wheuer/LEDCube/Docs/Images/box-turtle-silhouette-000000-original.png

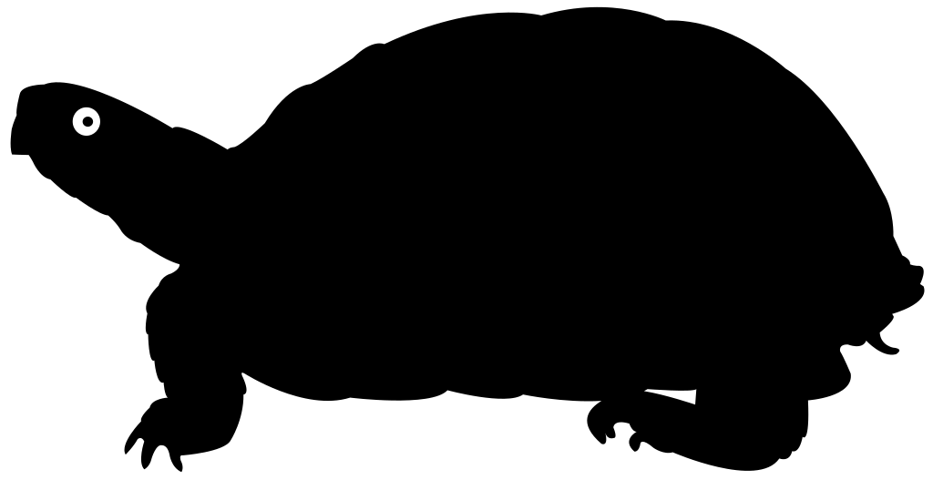
Docs/Images/box-turtle-silhouette-000000-original.png
