wheuer/LEDCube/Docs/Images/temp_pinout.png

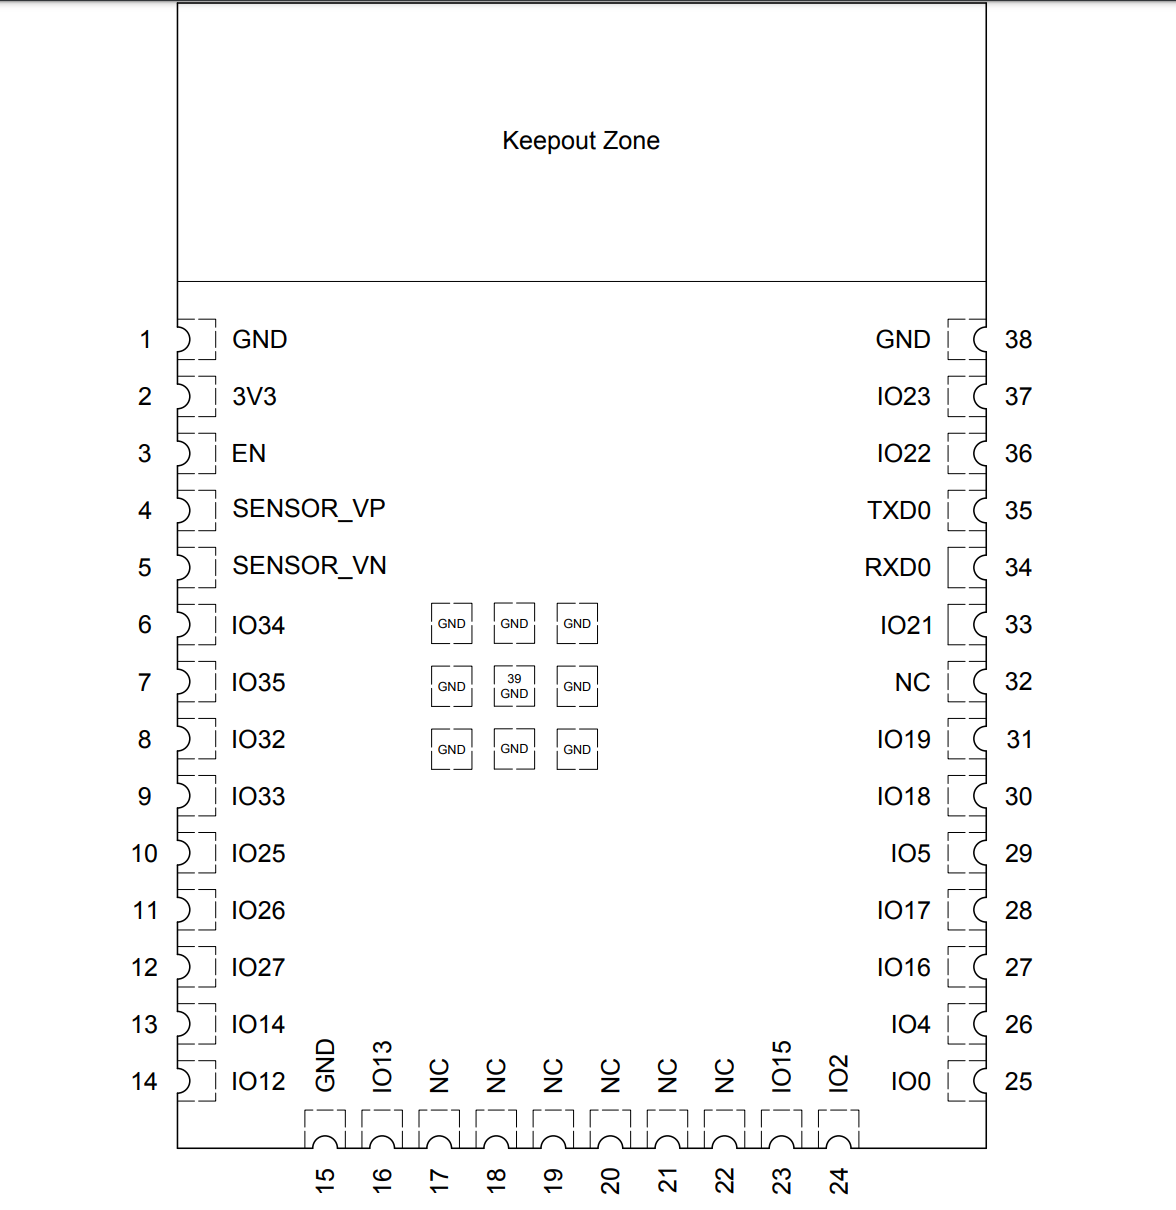
Docs/Images/temp_pinout.png
