wheuer/LEDCube/KiCadPanel/KiCadPanel/KiCadPanel.kicad_pcb

## KiCad design KiCadPanel/KiCadPanel/KiCadPanel.kicad_pcb (2023-10-04)

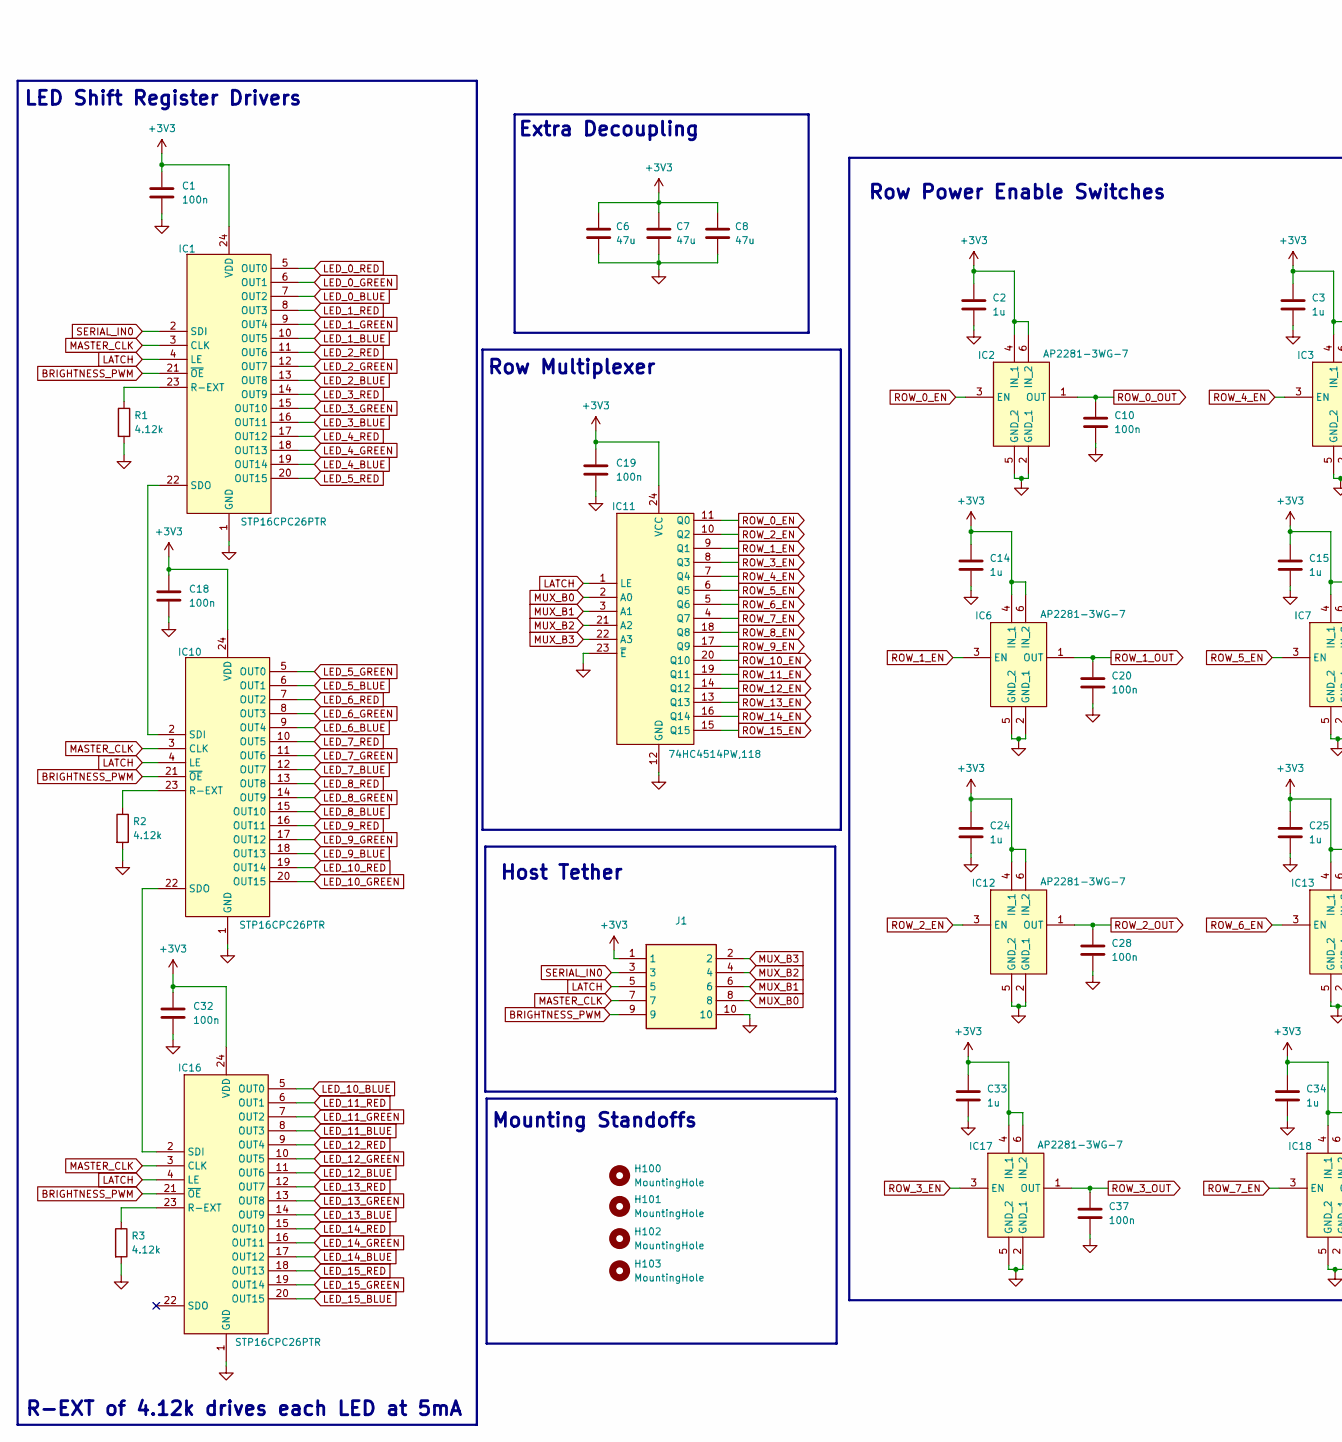
[picture p3: schematic KiCadPanel.kicad_sch, part in row 1, column 1]

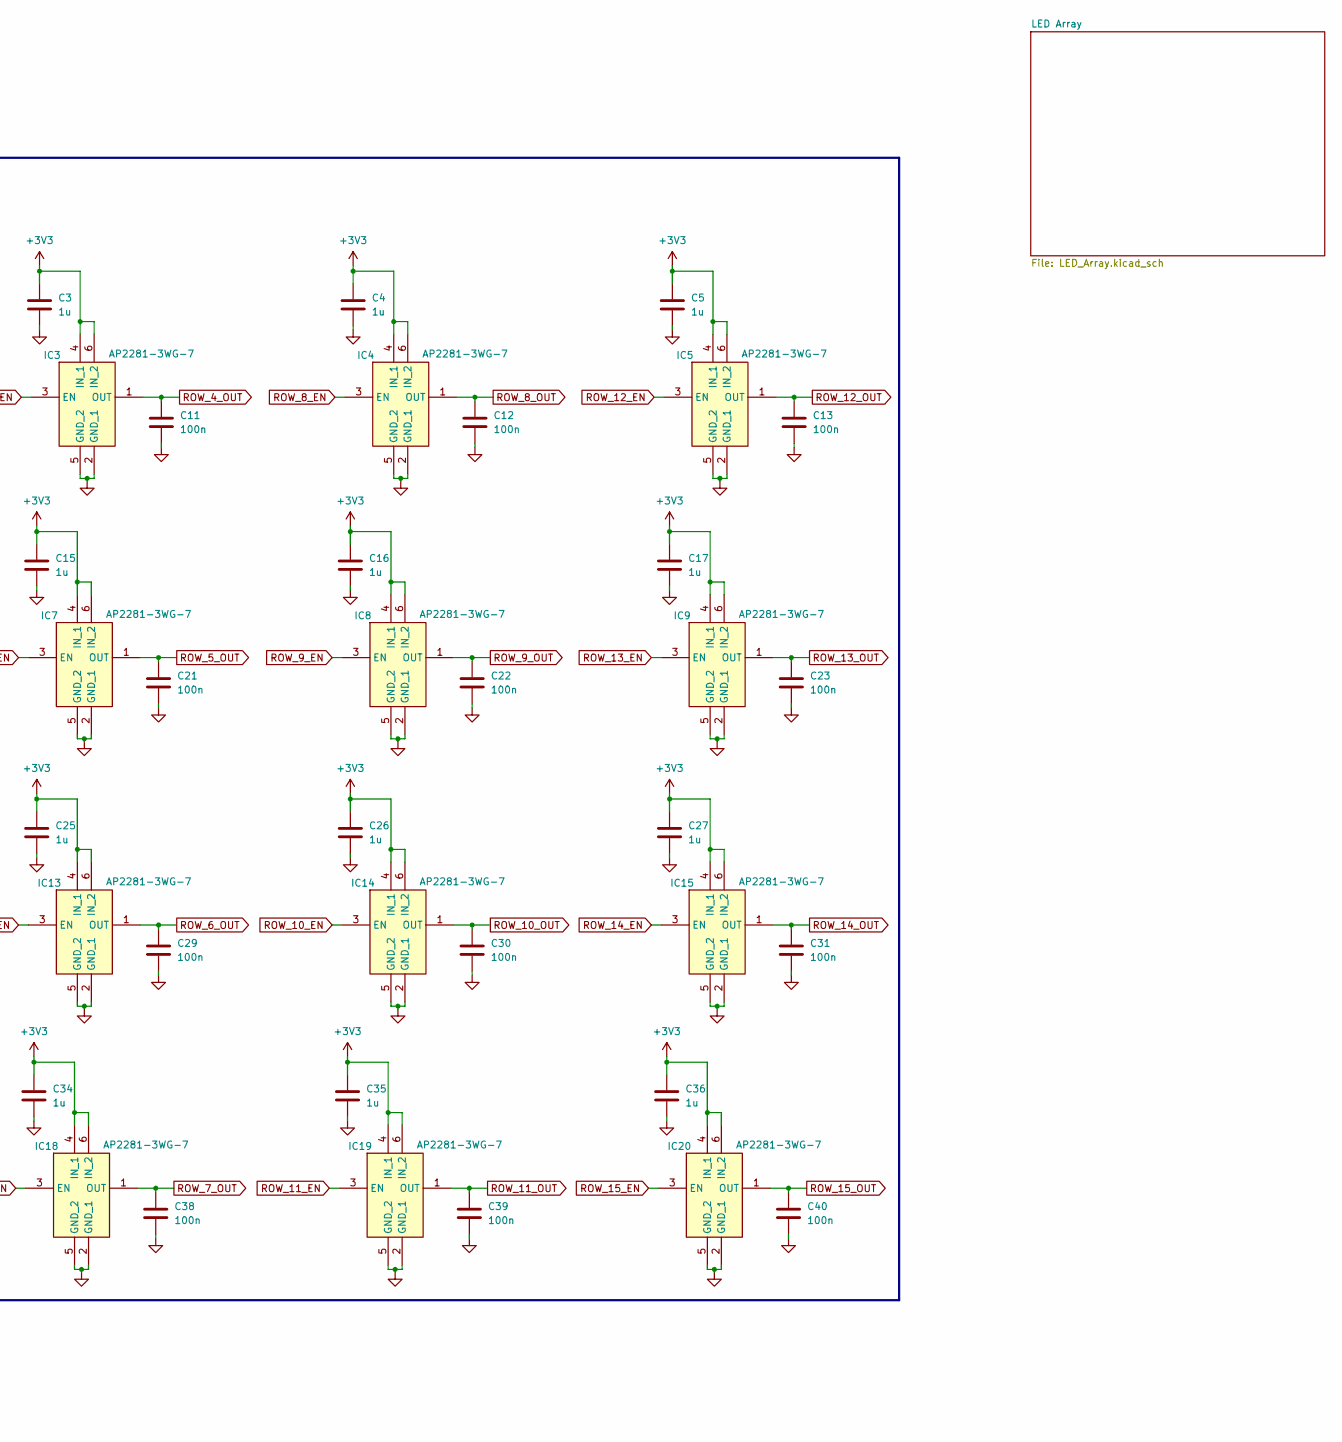
[picture p4: schematic KiCadPanel.kicad_sch, part in row 1, column 2]

Parts:
C1, C10, C11, C12, C13, C18, C19, C20, C21, C22, C23, C28, C29, C30, C31, C32, C37, C38, C39, C40: 100n; C_0603_1608Metric
C2, C3, C4, C5, C14, C15, C16, C17, C24, C25, C26, C27, C33, C34, C35, C36: 1u; C_0603_1608Metric
C6, C7, C8: 47u; C_1206_3216Metric
H100, H101, H102, H103: MountingHole; Mounting_Wuerth_WA-SMSE-ExternalM3_H5mm_9771050360
IC1, IC10, IC16: STP16CPC26PTR; SOP64P600X173-24N; Mouser Part Number 511-STP16CPC26PTR
IC2, IC3, IC4, IC5, IC6, IC7, IC8, IC9, IC12, IC13, IC14, IC15, IC17, IC18, IC19, IC20: AP2281-3WG-7; SOT95P285X140-6N; Mouser Part Number 621-AP2281-3WG-7
IC11: 74HC4514PW,118; SOP65P640X110-24N; Mouser Part Number 771-HC4514PW118
J1: CNC_TECH_SMD_10POS; Manufacturer_Part_Number 15-91-0100
R1, R2, R3: 4.12k; R_0603_1608Metric

Connections:
+3V3: C1.1, C2.1, C3.1, C4.1, C5.1, C6.1, C7.1, C8.1, C14.1, C15.1, C16.1, C17.1, C18.1, C19.1, C24.1, C25.1, C26.1, C27.1, C32.1, C33.1, C34.1, C35.1, C36.1, IC1.24 (VDD), IC2.4 (IN_1), IC2.6 (IN_2), IC3.4 (IN_1), IC3.6 (IN_2), IC4.4 (IN_1), IC4.6 (IN_2), IC5.4 (IN_1), IC5.6 (IN_2), IC6.4 (IN_1), IC6.6 (IN_2), IC7.4 (IN_1), IC7.6 (IN_2), IC8.4 (IN_1), IC8.6 (IN_2), IC9.4 (IN_1), IC9.6 (IN_2), IC10.24 (VDD), IC11.24 (VCC), IC12.4 (IN_1), IC12.6 (IN_2), IC13.4 (IN_1), IC13.6 (IN_2), IC14.4 (IN_1), IC14.6 (IN_2), IC15.4 (IN_1), IC15.6 (IN_2), IC16.24 (VDD), IC17.4 (IN_1), IC17.6 (IN_2), IC18.4 (IN_1), IC18.6 (IN_2), IC19.4 (IN_1), IC19.6 (IN_2), IC20.4 (IN_1), IC20.6 (IN_2), J1.1
BRIGHTNESS_PWM: IC1.21 (~OE), IC10.21 (~OE), IC16.21 (~OE), J1.9
GND: C1.2, C2.2, C3.2, C4.2, C5.2, C6.2, C7.2, C8.2, C10.2, C11.2, C12.2, C13.2, C14.2, C15.2, C16.2, C17.2, C18.2, C19.2, C20.2, C21.2, C22.2, C23.2, C24.2, C25.2, C26.2, C27.2, C28.2, C29.2, C30.2, C31.2, C32.2, C33.2, C34.2, C35.2, C36.2, C37.2, C38.2, C39.2, C40.2, IC1.1 (GND), IC2.2 (GND_1), IC2.5 (GND_2), IC3.2 (GND_1), IC3.5 (GND_2), IC4.2 (GND_1), IC4.5 (GND_2), IC5.2 (GND_1), IC5.5 (GND_2), IC6.2 (GND_1), IC6.5 (GND_2), IC7.2 (GND_1), IC7.5 (GND_2), IC8.2 (GND_1), IC8.5 (GND_2), IC9.2 (GND_1), IC9.5 (GND_2), IC10.1 (GND), IC11.12 (GND), IC11.23 (~E), IC12.2 (GND_1), IC12.5 (GND_2), IC13.2 (GND_1), IC13.5 (GND_2), IC14.2 (GND_1), IC14.5 (GND_2), IC15.2 (GND_1), IC15.5 (GND_2), IC16.1 (GND), IC17.2 (GND_1), IC17.5 (GND_2), IC18.2 (GND_1), IC18.5 (GND_2), IC19.2 (GND_1), IC19.5 (GND_2), IC20.2 (GND_1), IC20.5 (GND_2), J1.10, R1.2, R2.2, R3.2
LATCH: IC1.4 (LE), IC10.4 (LE), IC11.1 (LE), IC16.4 (LE), J1.5
LED_0_BLUE: IC1.7 (OUT2); also elsewhere on the board
LED_0_GREEN: IC1.6 (OUT1); also elsewhere on the board
LED_0_RED: IC1.5 (OUT0); also elsewhere on the board
LED_1_BLUE: IC1.10 (OUT5); also elsewhere on the board
LED_1_GREEN: IC1.9 (OUT4); also elsewhere on the board
LED_1_RED: IC1.8 (OUT3); also elsewhere on the board
LED_2_BLUE: IC1.13 (OUT8); also elsewhere on the board
LED_2_GREEN: IC1.12 (OUT7); also elsewhere on the board
LED_2_RED: IC1.11 (OUT6); also elsewhere on the board
LED_3_BLUE: IC1.16 (OUT11); also elsewhere on the board
LED_3_GREEN: IC1.15 (OUT10); also elsewhere on the board
LED_3_RED: IC1.14 (OUT9); also elsewhere on the board
LED_4_BLUE: IC1.19 (OUT14); also elsewhere on the board
LED_4_GREEN: IC1.18 (OUT13); also elsewhere on the board
LED_4_RED: IC1.17 (OUT12); also elsewhere on the board
LED_5_BLUE: IC10.6 (OUT1); also elsewhere on the board
LED_5_GREEN: IC10.5 (OUT0); also elsewhere on the board
LED_5_RED: IC1.20 (OUT15); also elsewhere on the board
LED_6_BLUE: IC10.9 (OUT4); also elsewhere on the board
LED_6_GREEN: IC10.8 (OUT3); also elsewhere on the board
LED_6_RED: IC10.7 (OUT2); also elsewhere on the board
LED_7_BLUE: IC10.12 (OUT7); also elsewhere on the board
LED_7_GREEN: IC10.11 (OUT6); also elsewhere on the board
LED_7_RED: IC10.10 (OUT5); also elsewhere on the board
LED_8_BLUE: IC10.15 (OUT10); also elsewhere on the board
LED_8_GREEN: IC10.14 (OUT9); also elsewhere on the board
LED_8_RED: IC10.13 (OUT8); also elsewhere on the board
LED_9_BLUE: IC10.18 (OUT13); also elsewhere on the board
LED_9_GREEN: IC10.17 (OUT12); also elsewhere on the board
LED_9_RED: IC10.16 (OUT11); also elsewhere on the board
LED_10_BLUE: IC16.5 (OUT0); also elsewhere on the board
LED_10_GREEN: IC10.20 (OUT15); also elsewhere on the board
LED_10_RED: IC10.19 (OUT14); also elsewhere on the board
LED_11_BLUE: IC16.8 (OUT3); also elsewhere on the board
LED_11_GREEN: IC16.7 (OUT2); also elsewhere on the board
LED_11_RED: IC16.6 (OUT1); also elsewhere on the board
LED_12_BLUE: IC16.11 (OUT6); also elsewhere on the board
LED_12_GREEN: IC16.10 (OUT5); also elsewhere on the board
LED_12_RED: IC16.9 (OUT4); also elsewhere on the board
LED_13_BLUE: IC16.14 (OUT9); also elsewhere on the board
LED_13_GREEN: IC16.13 (OUT8); also elsewhere on the board
LED_13_RED: IC16.12 (OUT7); also elsewhere on the board
LED_14_BLUE: IC16.17 (OUT12); also elsewhere on the board
LED_14_GREEN: IC16.16 (OUT11); also elsewhere on the board
LED_14_RED: IC16.15 (OUT10); also elsewhere on the board
LED_15_BLUE: IC16.20 (OUT15); also elsewhere on the board
LED_15_GREEN: IC16.19 (OUT14); also elsewhere on the board
LED_15_RED: IC16.18 (OUT13); also elsewhere on the board
MASTER_CLK: IC1.3 (CLK), IC10.3 (CLK), IC16.3 (CLK), J1.7
MUX_B0: IC11.2 (A0), J1.8
MUX_B1: IC11.3 (A1), J1.6
MUX_B2: IC11.21 (A2), J1.4
MUX_B3: IC11.22 (A3), J1.2
unnamed: IC1.23 (R-EXT), R1.1
unnamed: IC1.22 (SDO), IC10.2 (SDI)
unnamed: IC10.23 (R-EXT), R2.1
unnamed: IC10.22 (SDO), IC16.2 (SDI)
unnamed: IC16.23 (R-EXT), R3.1
ROW_0_EN: IC2.3 (EN), IC11.11 (Q0)
ROW_0_OUT: C10.1, IC2.1 (OUT); also elsewhere on the board
ROW_1_EN: IC6.3 (EN), IC11.9 (Q1)
ROW_1_OUT: C20.1, IC6.1 (OUT); also elsewhere on the board
ROW_2_EN: IC11.10 (Q2), IC12.3 (EN)
ROW_2_OUT: C28.1, IC12.1 (OUT); also elsewhere on the board
ROW_3_EN: IC11.8 (Q3), IC17.3 (EN)
ROW_3_OUT: C37.1, IC17.1 (OUT); also elsewhere on the board
ROW_4_EN: IC3.3 (EN), IC11.7 (Q4)
ROW_4_OUT: C11.1, IC3.1 (OUT); also elsewhere on the board
ROW_5_EN: IC7.3 (EN), IC11.6 (Q5)
ROW_5_OUT: C21.1, IC7.1 (OUT); also elsewhere on the board
ROW_6_EN: IC11.5 (Q6), IC13.3 (EN)
ROW_6_OUT: C29.1, IC13.1 (OUT); also elsewhere on the board
ROW_7_EN: IC11.4 (Q7), IC18.3 (EN)
ROW_7_OUT: C38.1, IC18.1 (OUT); also elsewhere on the board
ROW_8_EN: IC4.3 (EN), IC11.18 (Q8)
ROW_8_OUT: C12.1, IC4.1 (OUT); also elsewhere on the board
ROW_9_EN: IC8.3 (EN), IC11.17 (Q9)
ROW_9_OUT: C22.1, IC8.1 (OUT); also elsewhere on the board
ROW_10_EN: IC11.20 (Q10), IC14.3 (EN)
ROW_10_OUT: C30.1, IC14.1 (OUT); also elsewhere on the board
ROW_11_EN: IC11.19 (Q11), IC19.3 (EN)
ROW_11_OUT: C39.1, IC19.1 (OUT); also elsewhere on the board
ROW_12_EN: IC5.3 (EN), IC11.14 (Q12)
ROW_12_OUT: C13.1, IC5.1 (OUT); also elsewhere on the board
ROW_13_EN: IC9.3 (EN), IC11.13 (Q13)
ROW_13_OUT: C23.1, IC9.1 (OUT); also elsewhere on the board
ROW_14_EN: IC11.16 (Q14), IC15.3 (EN)
ROW_14_OUT: C31.1, IC15.1 (OUT); also elsewhere on the board
ROW_15_EN: IC11.15 (Q15), IC20.3 (EN)
ROW_15_OUT: C40.1, IC20.1 (OUT); also elsewhere on the board
SERIAL_IN0: IC1.2 (SDI), J1.3

Notes on the sheet:
LED Shift Register Drivers
Row Power Enable Switches
R-EXT of 4.12k drives each LED at 5mA
Host Tether
Row Multiplexer
Extra Decoupling
Mounting Standoffs
