wheuer/LEDCube/KiCadPanel/KiCadPanel/KiCadPanel.kicad_pcb

## KiCad design KiCadPanel/KiCadPanel/KiCadPanel.kicad_pcb (continued)

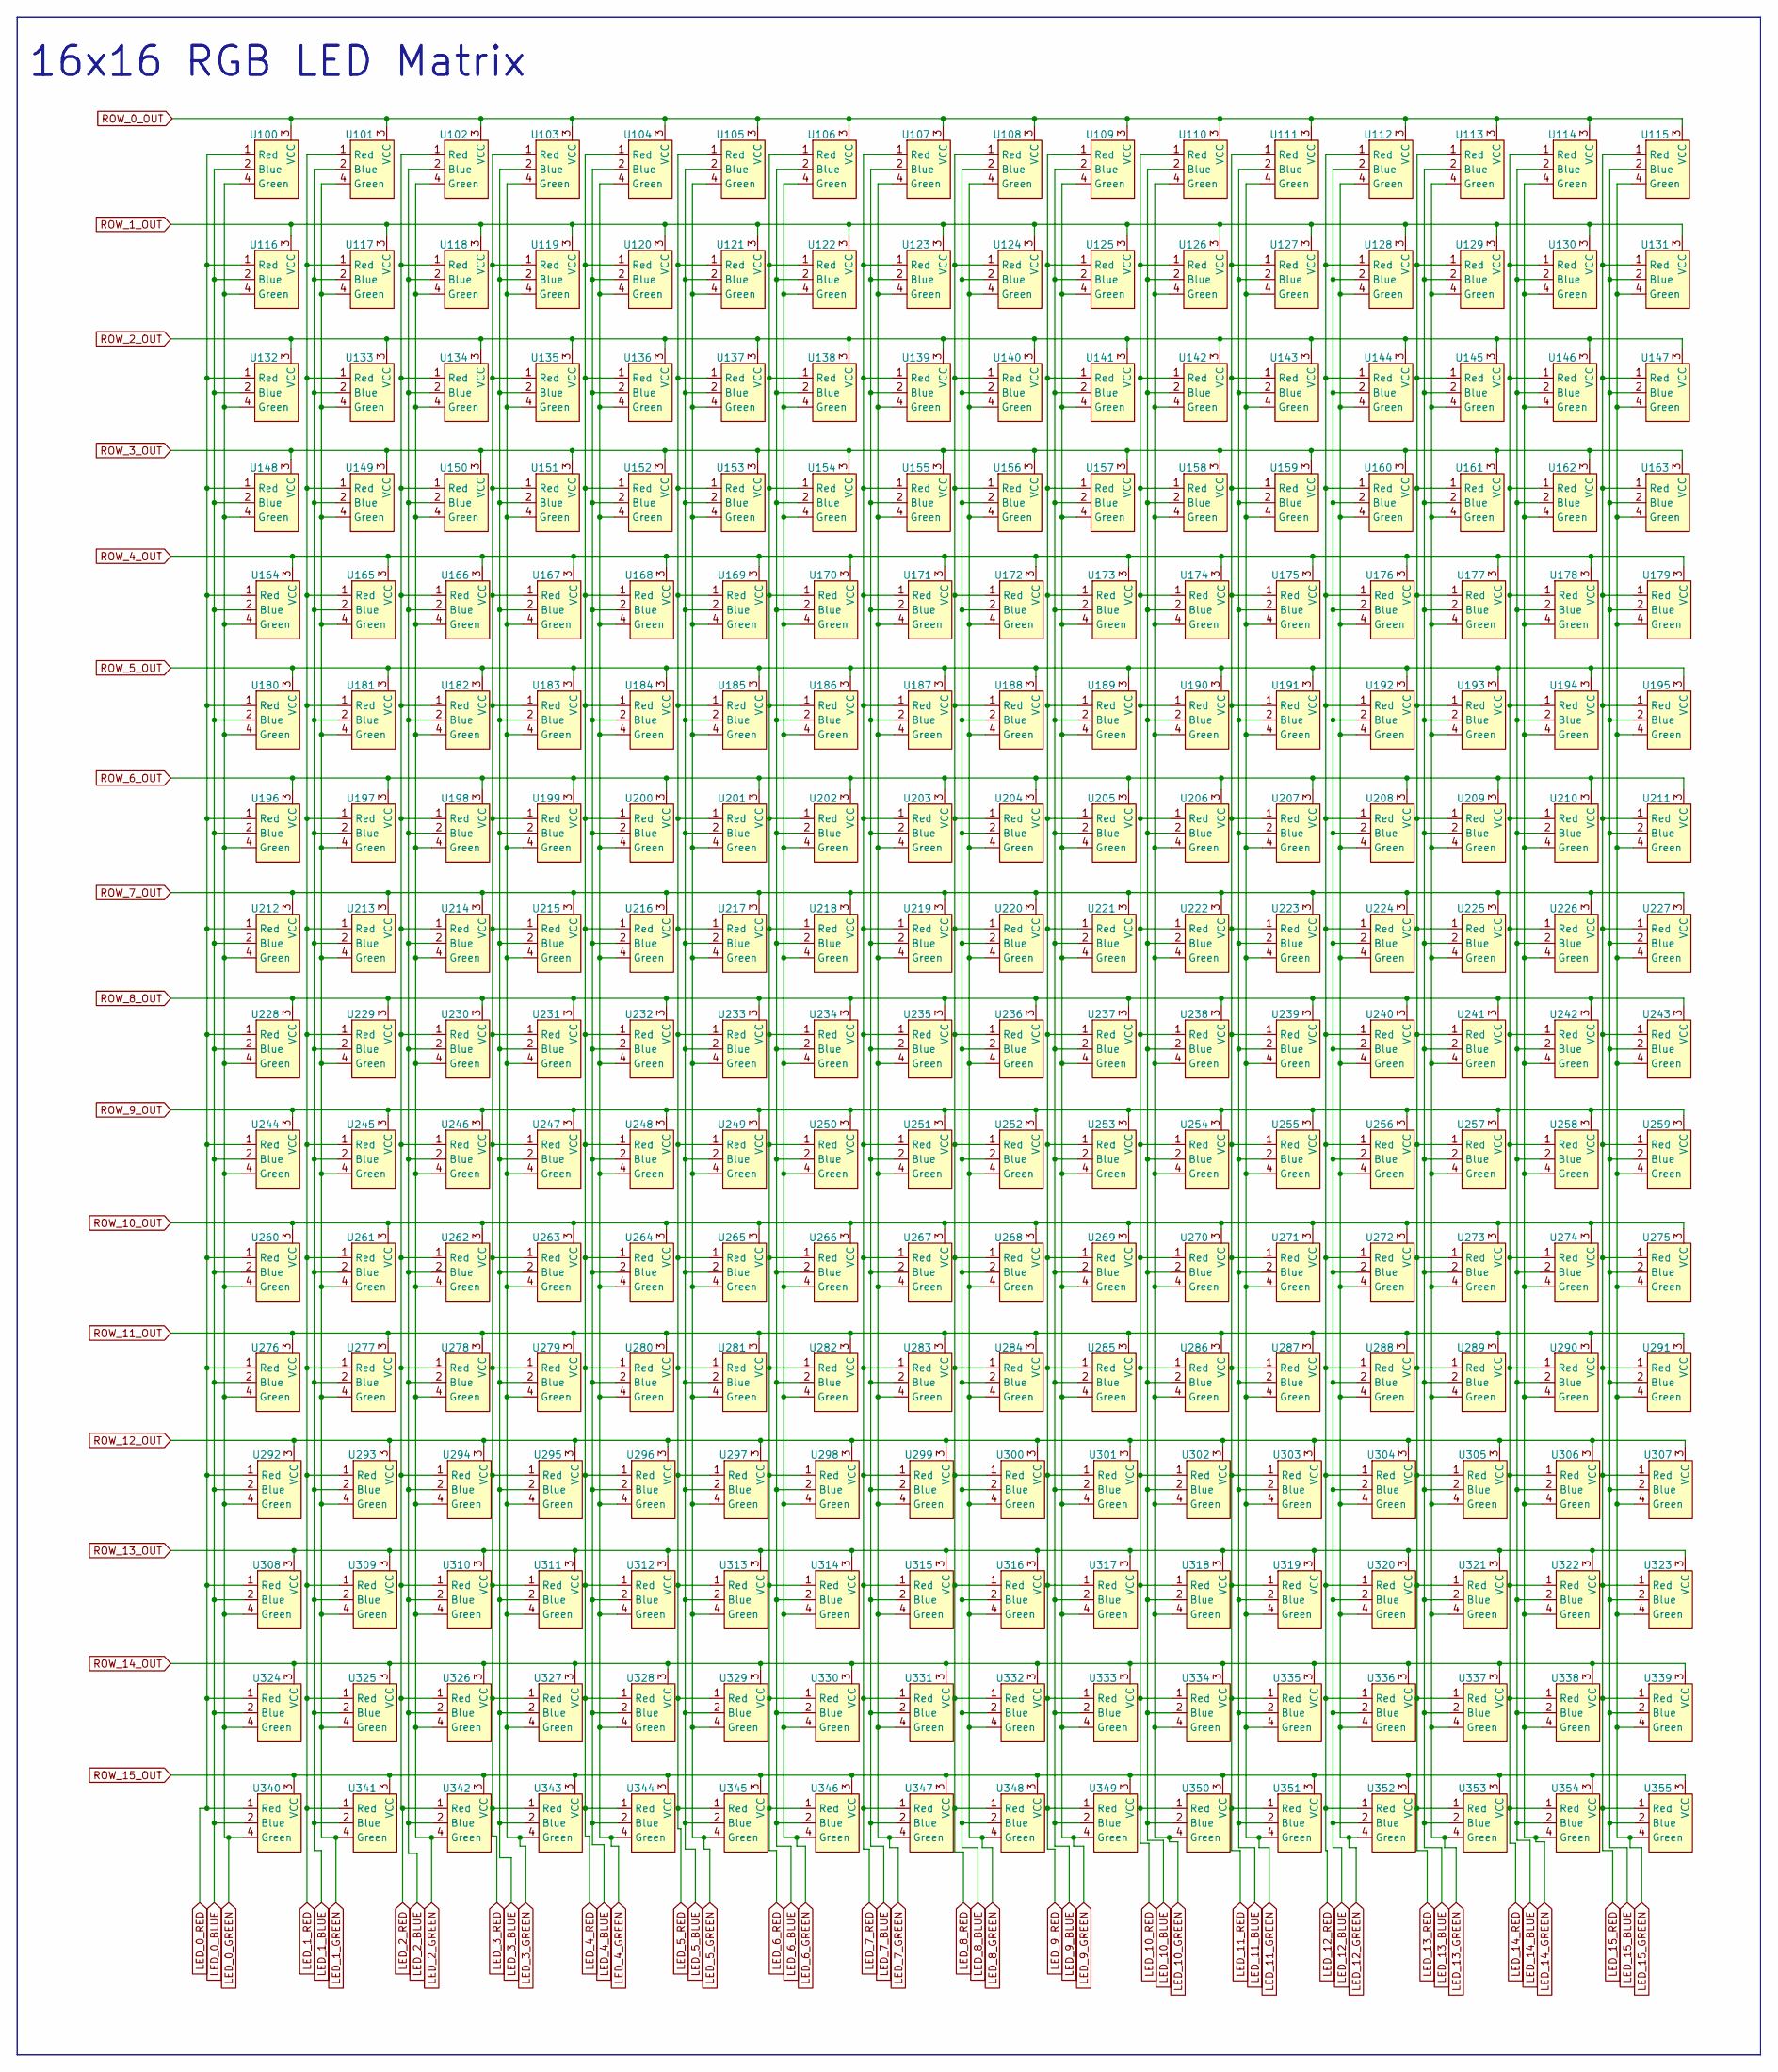
[picture p5: schematic LED_Array.kicad_sch]

Parts:
U100, U101, U102, U103, U104, U105, U106, U107, U108, U109, U110, U111, U112, U113, U114, U115, U116, U117, U118, U119, U120, U121, U122, U123, U124, U125, U126, U127, U128, U129, U130, U131, U132, U133, U134, U135, U136, U137, U138, U139, U140, U141, U142, U143, U144, U145, U146, U147, U148, U149, U150, U151, U152, U153, U154, U155, U156, U157, U158, U159, U160, U161, U162, U163, U164, U165, U166, U167, U168, U169, U170, U171, U172, U173, U174, U175, U176, U177, U178, U179, U180, U181, U182, U183, U184, U185, U186, U187, U188, U189, U190, U191, U192, U193, U194, U195, U196, U197, U198, U199, U200, U201, U202, U203, U204, U205, U206, U207, U208, U209, U210, U211, U212, U213, U214, U215, U216, U217, U218, U219, U220, U221, U222, U223, U224, U225, U226, U227, U228, U229, U230, U231, U232, U233, U234, U235, U236, U237, U238, U239, U240, U241, U242, U243, U244, U245, U246, U247, U248, U249, U250, U251, U252, U253, U254, U255, U256, U257, U258, U259, U260, U261, U262, U263, U264, U265, U266, U267, U268, U269, U270, U271, U272, U273, U274, U275, U276, U277, U278, U279, U280, U281, U282, U283, U284, U285, U286, U287, U288, U289, U290, U291, U292, U293, U294, U295, U296, U297, U298, U299, U300, U301, U302, U303, U304, U305, U306, U307, U308, U309, U310, U311, U312, U313, U314, U315, U316, U317, U318, U319, U320, U321, U322, U323, U324, U325, U326, U327, U328, U329, U330, U331, U332, U333, U334, U335, U336, U337, U338, U339, U340, U341, U342, U343, U344, U345, U346, U347, U348, U349, U350, U351, U352, U353, U354, U355: 2.1x2.1_LED

Connections:
LED_0_BLUE: U100.2 (Blue), U116.2 (Blue), U132.2 (Blue), U148.2 (Blue), U164.2 (Blue), U180.2 (Blue), U196.2 (Blue), U212.2 (Blue), U228.2 (Blue), U244.2 (Blue), U260.2 (Blue), U276.2 (Blue), U292.2 (Blue), U308.2 (Blue), U324.2 (Blue), U340.2 (Blue); also elsewhere on the board
LED_0_GREEN: U100.4 (Green), U116.4 (Green), U132.4 (Green), U148.4 (Green), U164.4 (Green), U180.4 (Green), U196.4 (Green), U212.4 (Green), U228.4 (Green), U244.4 (Green), U260.4 (Green), U276.4 (Green), U292.4 (Green), U308.4 (Green), U324.4 (Green), U340.4 (Green); also elsewhere on the board
LED_0_RED: U100.1 (Red), U116.1 (Red), U132.1 (Red), U148.1 (Red), U164.1 (Red), U180.1 (Red), U196.1 (Red), U212.1 (Red), U228.1 (Red), U244.1 (Red), U260.1 (Red), U276.1 (Red), U292.1 (Red), U308.1 (Red), U324.1 (Red), U340.1 (Red); also elsewhere on the board
LED_1_BLUE: U101.2 (Blue), U117.2 (Blue), U133.2 (Blue), U149.2 (Blue), U165.2 (Blue), U181.2 (Blue), U197.2 (Blue), U213.2 (Blue), U229.2 (Blue), U245.2 (Blue), U261.2 (Blue), U277.2 (Blue), U293.2 (Blue), U309.2 (Blue), U325.2 (Blue), U341.2 (Blue); also elsewhere on the board
LED_1_GREEN: U101.4 (Green), U117.4 (Green), U133.4 (Green), U149.4 (Green), U165.4 (Green), U181.4 (Green), U197.4 (Green), U213.4 (Green), U229.4 (Green), U245.4 (Green), U261.4 (Green), U277.4 (Green), U293.4 (Green), U309.4 (Green), U325.4 (Green), U341.4 (Green); also elsewhere on the board
LED_1_RED: U101.1 (Red), U117.1 (Red), U133.1 (Red), U149.1 (Red), U165.1 (Red), U181.1 (Red), U197.1 (Red), U213.1 (Red), U229.1 (Red), U245.1 (Red), U261.1 (Red), U277.1 (Red), U293.1 (Red), U309.1 (Red), U325.1 (Red), U341.1 (Red); also elsewhere on the board
LED_2_BLUE: U102.2 (Blue), U118.2 (Blue), U134.2 (Blue), U150.2 (Blue), U166.2 (Blue), U182.2 (Blue), U198.2 (Blue), U214.2 (Blue), U230.2 (Blue), U246.2 (Blue), U262.2 (Blue), U278.2 (Blue), U294.2 (Blue), U310.2 (Blue), U326.2 (Blue), U342.2 (Blue); also elsewhere on the board
LED_2_GREEN: U102.4 (Green), U118.4 (Green), U134.4 (Green), U150.4 (Green), U166.4 (Green), U182.4 (Green), U198.4 (Green), U214.4 (Green), U230.4 (Green), U246.4 (Green), U262.4 (Green), U278.4 (Green), U294.4 (Green), U310.4 (Green), U326.4 (Green), U342.4 (Green); also elsewhere on the board
LED_2_RED: U102.1 (Red), U118.1 (Red), U134.1 (Red), U150.1 (Red), U166.1 (Red), U182.1 (Red), U198.1 (Red), U214.1 (Red), U230.1 (Red), U246.1 (Red), U262.1 (Red), U278.1 (Red), U294.1 (Red), U310.1 (Red), U326.1 (Red), U342.1 (Red); also elsewhere on the board
LED_3_BLUE: U103.2 (Blue), U119.2 (Blue), U135.2 (Blue), U151.2 (Blue), U167.2 (Blue), U183.2 (Blue), U199.2 (Blue), U215.2 (Blue), U231.2 (Blue), U247.2 (Blue), U263.2 (Blue), U279.2 (Blue), U295.2 (Blue), U311.2 (Blue), U327.2 (Blue), U343.2 (Blue); also elsewhere on the board
LED_3_GREEN: U103.4 (Green), U119.4 (Green), U135.4 (Green), U151.4 (Green), U167.4 (Green), U183.4 (Green), U199.4 (Green), U215.4 (Green), U231.4 (Green), U247.4 (Green), U263.4 (Green), U279.4 (Green), U295.4 (Green), U311.4 (Green), U327.4 (Green), U343.4 (Green); also elsewhere on the board
LED_3_RED: U103.1 (Red), U119.1 (Red), U135.1 (Red), U151.1 (Red), U167.1 (Red), U183.1 (Red), U199.1 (Red), U215.1 (Red), U231.1 (Red), U247.1 (Red), U263.1 (Red), U279.1 (Red), U295.1 (Red), U311.1 (Red), U327.1 (Red), U343.1 (Red); also elsewhere on the board
LED_4_BLUE: U104.2 (Blue), U120.2 (Blue), U136.2 (Blue), U152.2 (Blue), U168.2 (Blue), U184.2 (Blue), U200.2 (Blue), U216.2 (Blue), U232.2 (Blue), U248.2 (Blue), U264.2 (Blue), U280.2 (Blue), U296.2 (Blue), U312.2 (Blue), U328.2 (Blue), U344.2 (Blue); also elsewhere on the board
LED_4_GREEN: U104.4 (Green), U120.4 (Green), U136.4 (Green), U152.4 (Green), U168.4 (Green), U184.4 (Green), U200.4 (Green), U216.4 (Green), U232.4 (Green), U248.4 (Green), U264.4 (Green), U280.4 (Green), U296.4 (Green), U312.4 (Green), U328.4 (Green), U344.4 (Green); also elsewhere on the board
LED_4_RED: U104.1 (Red), U120.1 (Red), U136.1 (Red), U152.1 (Red), U168.1 (Red), U184.1 (Red), U200.1 (Red), U216.1 (Red), U232.1 (Red), U248.1 (Red), U264.1 (Red), U280.1 (Red), U296.1 (Red), U312.1 (Red), U328.1 (Red), U344.1 (Red); also elsewhere on the board
LED_5_BLUE: U105.2 (Blue), U121.2 (Blue), U137.2 (Blue), U153.2 (Blue), U169.2 (Blue), U185.2 (Blue), U201.2 (Blue), U217.2 (Blue), U233.2 (Blue), U249.2 (Blue), U265.2 (Blue), U281.2 (Blue), U297.2 (Blue), U313.2 (Blue), U329.2 (Blue), U345.2 (Blue); also elsewhere on the board
LED_5_GREEN: U105.4 (Green), U121.4 (Green), U137.4 (Green), U153.4 (Green), U169.4 (Green), U185.4 (Green), U201.4 (Green), U217.4 (Green), U233.4 (Green), U249.4 (Green), U265.4 (Green), U281.4 (Green), U297.4 (Green), U313.4 (Green), U329.4 (Green), U345.4 (Green); also elsewhere on the board
LED_5_RED: U105.1 (Red), U121.1 (Red), U137.1 (Red), U153.1 (Red), U169.1 (Red), U185.1 (Red), U201.1 (Red), U217.1 (Red), U233.1 (Red), U249.1 (Red), U265.1 (Red), U281.1 (Red), U297.1 (Red), U313.1 (Red), U329.1 (Red), U345.1 (Red); also elsewhere on the board
LED_6_BLUE: U106.2 (Blue), U122.2 (Blue), U138.2 (Blue), U154.2 (Blue), U170.2 (Blue), U186.2 (Blue), U202.2 (Blue), U218.2 (Blue), U234.2 (Blue), U250.2 (Blue), U266.2 (Blue), U282.2 (Blue), U298.2 (Blue), U314.2 (Blue), U330.2 (Blue), U346.2 (Blue); also elsewhere on the board
LED_6_GREEN: U106.4 (Green), U122.4 (Green), U138.4 (Green), U154.4 (Green), U170.4 (Green), U186.4 (Green), U202.4 (Green), U218.4 (Green), U234.4 (Green), U250.4 (Green), U266.4 (Green), U282.4 (Green), U298.4 (Green), U314.4 (Green), U330.4 (Green), U346.4 (Green); also elsewhere on the board
LED_6_RED: U106.1 (Red), U122.1 (Red), U138.1 (Red), U154.1 (Red), U170.1 (Red), U186.1 (Red), U202.1 (Red), U218.1 (Red), U234.1 (Red), U250.1 (Red), U266.1 (Red), U282.1 (Red), U298.1 (Red), U314.1 (Red), U330.1 (Red), U346.1 (Red); also elsewhere on the board
LED_7_BLUE: U107.2 (Blue), U123.2 (Blue), U139.2 (Blue), U155.2 (Blue), U171.2 (Blue), U187.2 (Blue), U203.2 (Blue), U219.2 (Blue), U235.2 (Blue), U251.2 (Blue), U267.2 (Blue), U283.2 (Blue), U299.2 (Blue), U315.2 (Blue), U331.2 (Blue), U347.2 (Blue); also elsewhere on the board
LED_7_GREEN: U107.4 (Green), U123.4 (Green), U139.4 (Green), U155.4 (Green), U171.4 (Green), U187.4 (Green), U203.4 (Green), U219.4 (Green), U235.4 (Green), U251.4 (Green), U267.4 (Green), U283.4 (Green), U299.4 (Green), U315.4 (Green), U331.4 (Green), U347.4 (Green); also elsewhere on the board
LED_7_RED: U107.1 (Red), U123.1 (Red), U139.1 (Red), U155.1 (Red), U171.1 (Red), U187.1 (Red), U203.1 (Red), U219.1 (Red), U235.1 (Red), U251.1 (Red), U267.1 (Red), U283.1 (Red), U299.1 (Red), U315.1 (Red), U331.1 (Red), U347.1 (Red); also elsewhere on the board
LED_8_BLUE: U108.2 (Blue), U124.2 (Blue), U140.2 (Blue), U156.2 (Blue), U172.2 (Blue), U188.2 (Blue), U204.2 (Blue), U220.2 (Blue), U236.2 (Blue), U252.2 (Blue), U268.2 (Blue), U284.2 (Blue), U300.2 (Blue), U316.2 (Blue), U332.2 (Blue), U348.2 (Blue); also elsewhere on the board
LED_8_GREEN: U108.4 (Green), U124.4 (Green), U140.4 (Green), U156.4 (Green), U172.4 (Green), U188.4 (Green), U204.4 (Green), U220.4 (Green), U236.4 (Green), U252.4 (Green), U268.4 (Green), U284.4 (Green), U300.4 (Green), U316.4 (Green), U332.4 (Green), U348.4 (Green); also elsewhere on the board
LED_8_RED: U108.1 (Red), U124.1 (Red), U140.1 (Red), U156.1 (Red), U172.1 (Red), U188.1 (Red), U204.1 (Red), U220.1 (Red), U236.1 (Red), U252.1 (Red), U268.1 (Red), U284.1 (Red), U300.1 (Red), U316.1 (Red), U332.1 (Red), U348.1 (Red); also elsewhere on the board
LED_9_BLUE: U109.2 (Blue), U125.2 (Blue), U141.2 (Blue), U157.2 (Blue), U173.2 (Blue), U189.2 (Blue), U205.2 (Blue), U221.2 (Blue), U237.2 (Blue), U253.2 (Blue), U269.2 (Blue), U285.2 (Blue), U301.2 (Blue), U317.2 (Blue), U333.2 (Blue), U349.2 (Blue); also elsewhere on the board
LED_9_GREEN: U109.4 (Green), U125.4 (Green), U141.4 (Green), U157.4 (Green), U173.4 (Green), U189.4 (Green), U205.4 (Green), U221.4 (Green), U237.4 (Green), U253.4 (Green), U269.4 (Green), U285.4 (Green), U301.4 (Green), U317.4 (Green), U333.4 (Green), U349.4 (Green); also elsewhere on the board
LED_9_RED: U109.1 (Red), U125.1 (Red), U141.1 (Red), U157.1 (Red), U173.1 (Red), U189.1 (Red), U205.1 (Red), U221.1 (Red), U237.1 (Red), U253.1 (Red), U269.1 (Red), U285.1 (Red), U301.1 (Red), U317.1 (Red), U333.1 (Red), U349.1 (Red); also elsewhere on the board
LED_10_BLUE: U110.2 (Blue), U126.2 (Blue), U142.2 (Blue), U158.2 (Blue), U174.2 (Blue), U190.2 (Blue), U206.2 (Blue), U222.2 (Blue), U238.2 (Blue), U254.2 (Blue), U270.2 (Blue), U286.2 (Blue), U302.2 (Blue), U318.2 (Blue), U334.2 (Blue), U350.2 (Blue); also elsewhere on the board
LED_10_GREEN: U110.4 (Green), U126.4 (Green), U142.4 (Green), U158.4 (Green), U174.4 (Green), U190.4 (Green), U206.4 (Green), U222.4 (Green), U238.4 (Green), U254.4 (Green), U270.4 (Green), U286.4 (Green), U302.4 (Green), U318.4 (Green), U334.4 (Green), U350.4 (Green); also elsewhere on the board
LED_10_RED: U110.1 (Red), U126.1 (Red), U142.1 (Red), U158.1 (Red), U174.1 (Red), U190.1 (Red), U206.1 (Red), U222.1 (Red), U238.1 (Red), U254.1 (Red), U270.1 (Red), U286.1 (Red), U302.1 (Red), U318.1 (Red), U334.1 (Red), U350.1 (Red); also elsewhere on the board
LED_11_BLUE: U111.2 (Blue), U127.2 (Blue), U143.2 (Blue), U159.2 (Blue), U175.2 (Blue), U191.2 (Blue), U207.2 (Blue), U223.2 (Blue), U239.2 (Blue), U255.2 (Blue), U271.2 (Blue), U287.2 (Blue), U303.2 (Blue), U319.2 (Blue), U335.2 (Blue), U351.2 (Blue); also elsewhere on the board
LED_11_GREEN: U111.4 (Green), U127.4 (Green), U143.4 (Green), U159.4 (Green), U175.4 (Green), U191.4 (Green), U207.4 (Green), U223.4 (Green), U239.4 (Green), U255.4 (Green), U271.4 (Green), U287.4 (Green), U303.4 (Green), U319.4 (Green), U335.4 (Green), U351.4 (Green); also elsewhere on the board
LED_11_RED: U111.1 (Red), U127.1 (Red), U143.1 (Red), U159.1 (Red), U175.1 (Red), U191.1 (Red), U207.1 (Red), U223.1 (Red), U239.1 (Red), U255.1 (Red), U271.1 (Red), U287.1 (Red), U303.1 (Red), U319.1 (Red), U335.1 (Red), U351.1 (Red); also elsewhere on the board
LED_12_BLUE: U112.2 (Blue), U128.2 (Blue), U144.2 (Blue), U160.2 (Blue), U176.2 (Blue), U192.2 (Blue), U208.2 (Blue), U224.2 (Blue), U240.2 (Blue), U256.2 (Blue), U272.2 (Blue), U288.2 (Blue), U304.2 (Blue), U320.2 (Blue), U336.2 (Blue), U352.2 (Blue); also elsewhere on the board
LED_12_GREEN: U112.4 (Green), U128.4 (Green), U144.4 (Green), U160.4 (Green), U176.4 (Green), U192.4 (Green), U208.4 (Green), U224.4 (Green), U240.4 (Green), U256.4 (Green), U272.4 (Green), U288.4 (Green), U304.4 (Green), U320.4 (Green), U336.4 (Green), U352.4 (Green); also elsewhere on the board
LED_12_RED: U112.1 (Red), U128.1 (Red), U144.1 (Red), U160.1 (Red), U176.1 (Red), U192.1 (Red), U208.1 (Red), U224.1 (Red), U240.1 (Red), U256.1 (Red), U272.1 (Red), U288.1 (Red), U304.1 (Red), U320.1 (Red), U336.1 (Red), U352.1 (Red); also elsewhere on the board
LED_13_BLUE: U113.2 (Blue), U129.2 (Blue), U145.2 (Blue), U161.2 (Blue), U177.2 (Blue), U193.2 (Blue), U209.2 (Blue), U225.2 (Blue), U241.2 (Blue), U257.2 (Blue), U273.2 (Blue), U289.2 (Blue), U305.2 (Blue), U321.2 (Blue), U337.2 (Blue), U353.2 (Blue); also elsewhere on the board
LED_13_GREEN: U113.4 (Green), U129.4 (Green), U145.4 (Green), U161.4 (Green), U177.4 (Green), U193.4 (Green), U209.4 (Green), U225.4 (Green), U241.4 (Green), U257.4 (Green), U273.4 (Green), U289.4 (Green), U305.4 (Green), U321.4 (Green), U337.4 (Green), U353.4 (Green); also elsewhere on the board
LED_13_RED: U113.1 (Red), U129.1 (Red), U145.1 (Red), U161.1 (Red), U177.1 (Red), U193.1 (Red), U209.1 (Red), U225.1 (Red), U241.1 (Red), U257.1 (Red), U273.1 (Red), U289.1 (Red), U305.1 (Red), U321.1 (Red), U337.1 (Red), U353.1 (Red); also elsewhere on the board
LED_14_BLUE: U114.2 (Blue), U130.2 (Blue), U146.2 (Blue), U162.2 (Blue), U178.2 (Blue), U194.2 (Blue), U210.2 (Blue), U226.2 (Blue), U242.2 (Blue), U258.2 (Blue), U274.2 (Blue), U290.2 (Blue), U306.2 (Blue), U322.2 (Blue), U338.2 (Blue), U354.2 (Blue); also elsewhere on the board
LED_14_GREEN: U114.4 (Green), U130.4 (Green), U146.4 (Green), U162.4 (Green), U178.4 (Green), U194.4 (Green), U210.4 (Green), U226.4 (Green), U242.4 (Green), U258.4 (Green), U274.4 (Green), U290.4 (Green), U306.4 (Green), U322.4 (Green), U338.4 (Green), U354.4 (Green); also elsewhere on the board
LED_14_RED: U114.1 (Red), U130.1 (Red), U146.1 (Red), U162.1 (Red), U178.1 (Red), U194.1 (Red), U210.1 (Red), U226.1 (Red), U242.1 (Red), U258.1 (Red), U274.1 (Red), U290.1 (Red), U306.1 (Red), U322.1 (Red), U338.1 (Red), U354.1 (Red); also elsewhere on the board
LED_15_BLUE: U115.2 (Blue), U131.2 (Blue), U147.2 (Blue), U163.2 (Blue), U179.2 (Blue), U195.2 (Blue), U211.2 (Blue), U227.2 (Blue), U243.2 (Blue), U259.2 (Blue), U275.2 (Blue), U291.2 (Blue), U307.2 (Blue), U323.2 (Blue), U339.2 (Blue), U355.2 (Blue); also elsewhere on the board
LED_15_GREEN: U115.4 (Green), U131.4 (Green), U147.4 (Green), U163.4 (Green), U179.4 (Green), U195.4 (Green), U211.4 (Green), U227.4 (Green), U243.4 (Green), U259.4 (Green), U275.4 (Green), U291.4 (Green), U307.4 (Green), U323.4 (Green), U339.4 (Green), U355.4 (Green); also elsewhere on the board
LED_15_RED: U115.1 (Red), U131.1 (Red), U147.1 (Red), U163.1 (Red), U179.1 (Red), U195.1 (Red), U211.1 (Red), U227.1 (Red), U243.1 (Red), U259.1 (Red), U275.1 (Red), U291.1 (Red), U307.1 (Red), U323.1 (Red), U339.1 (Red), U355.1 (Red); also elsewhere on the board
ROW_0_OUT: U100.3 (VCC), U101.3 (VCC), U102.3 (VCC), U103.3 (VCC), U104.3 (VCC), U105.3 (VCC), U106.3 (VCC), U107.3 (VCC), U108.3 (VCC), U109.3 (VCC), U110.3 (VCC), U111.3 (VCC), U112.3 (VCC), U113.3 (VCC), U114.3 (VCC), U115.3 (VCC); also elsewhere on the board
ROW_1_OUT: U116.3 (VCC), U117.3 (VCC), U118.3 (VCC), U119.3 (VCC), U120.3 (VCC), U121.3 (VCC), U122.3 (VCC), U123.3 (VCC), U124.3 (VCC), U125.3 (VCC), U126.3 (VCC), U127.3 (VCC), U128.3 (VCC), U129.3 (VCC), U130.3 (VCC), U131.3 (VCC); also elsewhere on the board
ROW_2_OUT: U132.3 (VCC), U133.3 (VCC), U134.3 (VCC), U135.3 (VCC), U136.3 (VCC), U137.3 (VCC), U138.3 (VCC), U139.3 (VCC), U140.3 (VCC), U141.3 (VCC), U142.3 (VCC), U143.3 (VCC), U144.3 (VCC), U145.3 (VCC), U146.3 (VCC), U147.3 (VCC); also elsewhere on the board
ROW_3_OUT: U148.3 (VCC), U149.3 (VCC), U150.3 (VCC), U151.3 (VCC), U152.3 (VCC), U153.3 (VCC), U154.3 (VCC), U155.3 (VCC), U156.3 (VCC), U157.3 (VCC), U158.3 (VCC), U159.3 (VCC), U160.3 (VCC), U161.3 (VCC), U162.3 (VCC), U163.3 (VCC); also elsewhere on the board
ROW_4_OUT: U164.3 (VCC), U165.3 (VCC), U166.3 (VCC), U167.3 (VCC), U168.3 (VCC), U169.3 (VCC), U170.3 (VCC), U171.3 (VCC), U172.3 (VCC), U173.3 (VCC), U174.3 (VCC), U175.3 (VCC), U176.3 (VCC), U177.3 (VCC), U178.3 (VCC), U179.3 (VCC); also elsewhere on the board
ROW_5_OUT: U180.3 (VCC), U181.3 (VCC), U182.3 (VCC), U183.3 (VCC), U184.3 (VCC), U185.3 (VCC), U186.3 (VCC), U187.3 (VCC), U188.3 (VCC), U189.3 (VCC), U190.3 (VCC), U191.3 (VCC), U192.3 (VCC), U193.3 (VCC), U194.3 (VCC), U195.3 (VCC); also elsewhere on the board
ROW_6_OUT: U196.3 (VCC), U197.3 (VCC), U198.3 (VCC), U199.3 (VCC), U200.3 (VCC), U201.3 (VCC), U202.3 (VCC), U203.3 (VCC), U204.3 (VCC), U205.3 (VCC), U206.3 (VCC), U207.3 (VCC), U208.3 (VCC), U209.3 (VCC), U210.3 (VCC), U211.3 (VCC); also elsewhere on the board
ROW_7_OUT: U212.3 (VCC), U213.3 (VCC), U214.3 (VCC), U215.3 (VCC), U216.3 (VCC), U217.3 (VCC), U218.3 (VCC), U219.3 (VCC), U220.3 (VCC), U221.3 (VCC), U222.3 (VCC), U223.3 (VCC), U224.3 (VCC), U225.3 (VCC), U226.3 (VCC), U227.3 (VCC); also elsewhere on the board
ROW_8_OUT: U228.3 (VCC), U229.3 (VCC), U230.3 (VCC), U231.3 (VCC), U232.3 (VCC), U233.3 (VCC), U234.3 (VCC), U235.3 (VCC), U236.3 (VCC), U237.3 (VCC), U238.3 (VCC), U239.3 (VCC), U240.3 (VCC), U241.3 (VCC), U242.3 (VCC), U243.3 (VCC); also elsewhere on the board
ROW_9_OUT: U244.3 (VCC), U245.3 (VCC), U246.3 (VCC), U247.3 (VCC), U248.3 (VCC), U249.3 (VCC), U250.3 (VCC), U251.3 (VCC), U252.3 (VCC), U253.3 (VCC), U254.3 (VCC), U255.3 (VCC), U256.3 (VCC), U257.3 (VCC), U258.3 (VCC), U259.3 (VCC); also elsewhere on the board
ROW_10_OUT: U260.3 (VCC), U261.3 (VCC), U262.3 (VCC), U263.3 (VCC), U264.3 (VCC), U265.3 (VCC), U266.3 (VCC), U267.3 (VCC), U268.3 (VCC), U269.3 (VCC), U270.3 (VCC), U271.3 (VCC), U272.3 (VCC), U273.3 (VCC), U274.3 (VCC), U275.3 (VCC); also elsewhere on the board
ROW_11_OUT: U276.3 (VCC), U277.3 (VCC), U278.3 (VCC), U279.3 (VCC), U280.3 (VCC), U281.3 (VCC), U282.3 (VCC), U283.3 (VCC), U284.3 (VCC), U285.3 (VCC), U286.3 (VCC), U287.3 (VCC), U288.3 (VCC), U289.3 (VCC), U290.3 (VCC), U291.3 (VCC); also elsewhere on the board
ROW_12_OUT: U292.3 (VCC), U293.3 (VCC), U294.3 (VCC), U295.3 (VCC), U296.3 (VCC), U297.3 (VCC), U298.3 (VCC), U299.3 (VCC), U300.3 (VCC), U301.3 (VCC), U302.3 (VCC), U303.3 (VCC), U304.3 (VCC), U305.3 (VCC), U306.3 (VCC), U307.3 (VCC); also elsewhere on the board
ROW_13_OUT: U308.3 (VCC), U309.3 (VCC), U310.3 (VCC), U311.3 (VCC), U312.3 (VCC), U313.3 (VCC), U314.3 (VCC), U315.3 (VCC), U316.3 (VCC), U317.3 (VCC), U318.3 (VCC), U319.3 (VCC), U320.3 (VCC), U321.3 (VCC), U322.3 (VCC), U323.3 (VCC); also elsewhere on the board
ROW_14_OUT: U324.3 (VCC), U325.3 (VCC), U326.3 (VCC), U327.3 (VCC), U328.3 (VCC), U329.3 (VCC), U330.3 (VCC), U331.3 (VCC), U332.3 (VCC), U333.3 (VCC), U334.3 (VCC), U335.3 (VCC), U336.3 (VCC), U337.3 (VCC), U338.3 (VCC), U339.3 (VCC); also elsewhere on the board
ROW_15_OUT: U340.3 (VCC), U341.3 (VCC), U342.3 (VCC), U343.3 (VCC), U344.3 (VCC), U345.3 (VCC), U346.3 (VCC), U347.3 (VCC), U348.3 (VCC), U349.3 (VCC), U350.3 (VCC), U351.3 (VCC), U352.3 (VCC), U353.3 (VCC), U354.3 (VCC), U355.3 (VCC); also elsewhere on the board

Notes on the sheet:
16x16 RGB LED Matrix

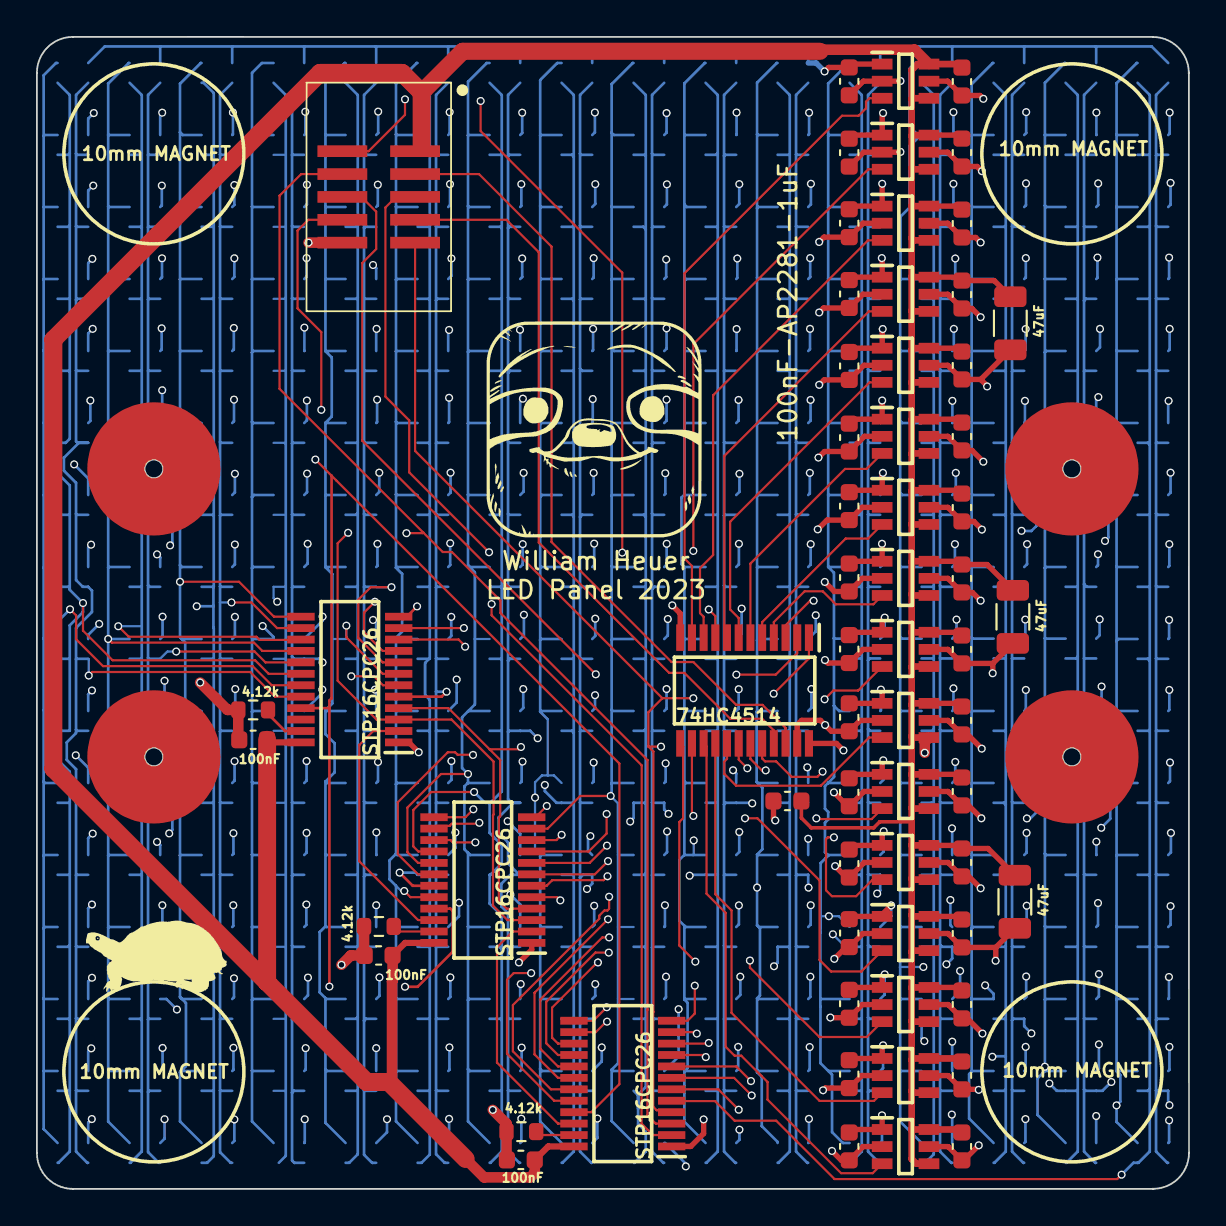
[picture p6: board KiCadPanel.kicad_pcb from above]

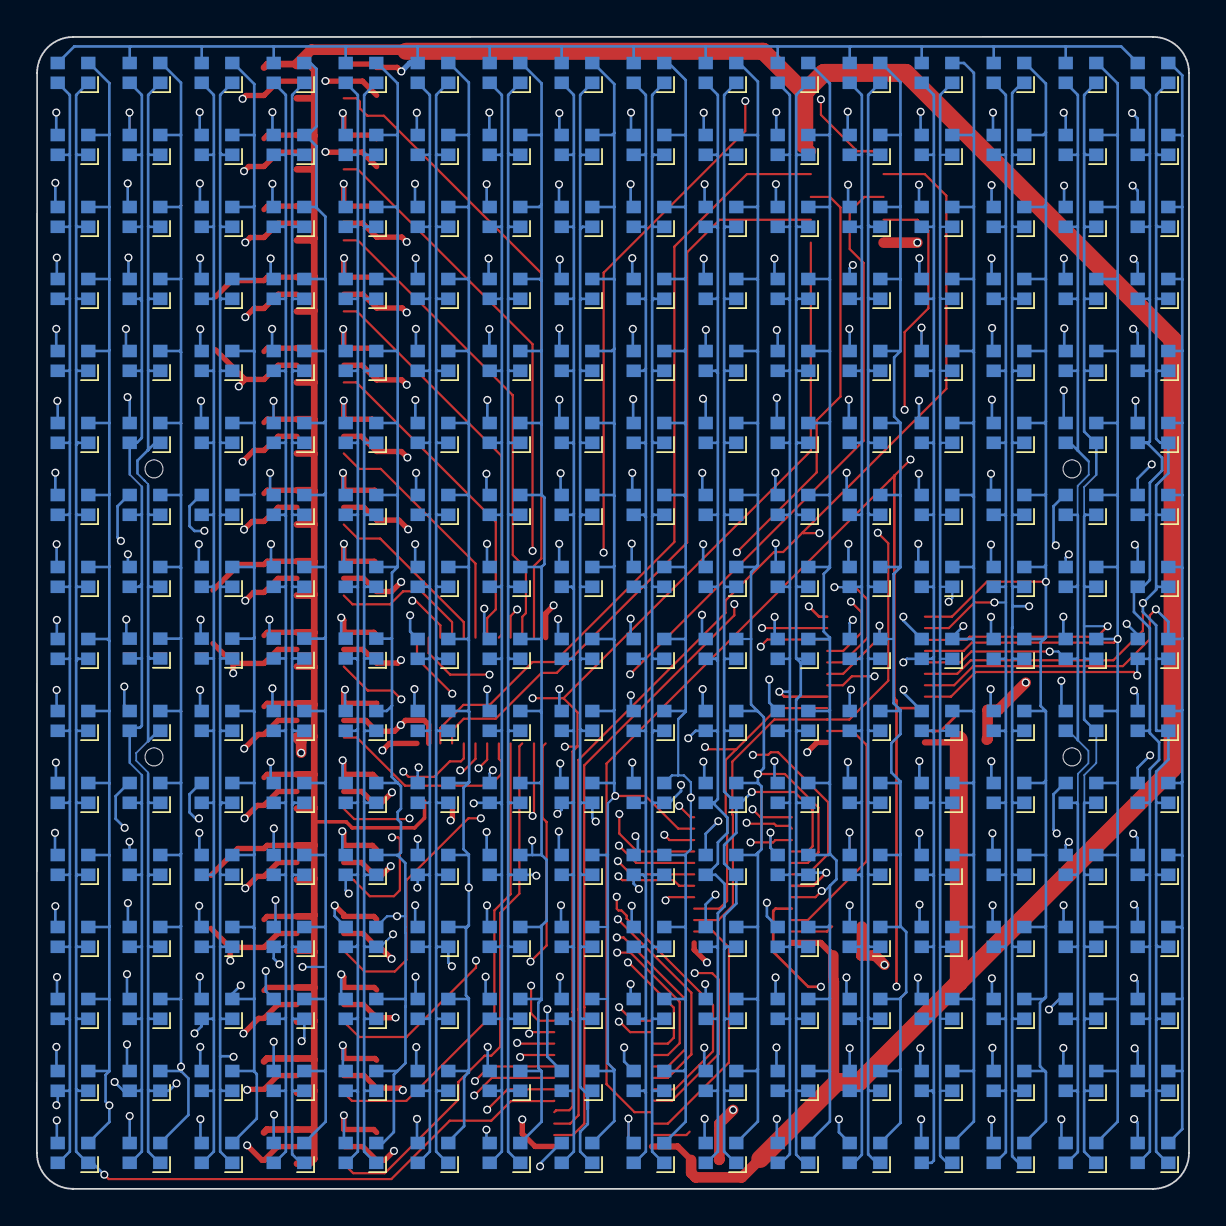
[picture p7: board KiCadPanel.kicad_pcb from below]

Board: 4 copper layers, 64.0 x 64.0 mm, 323 parts (256 on the bottom side), 95 nets.
