wheuer/LEDCube/KiCadController/LEDCube.kicad_pcb

## KiCad design KiCadController/LEDCube.kicad_pcb (2023-10-04)

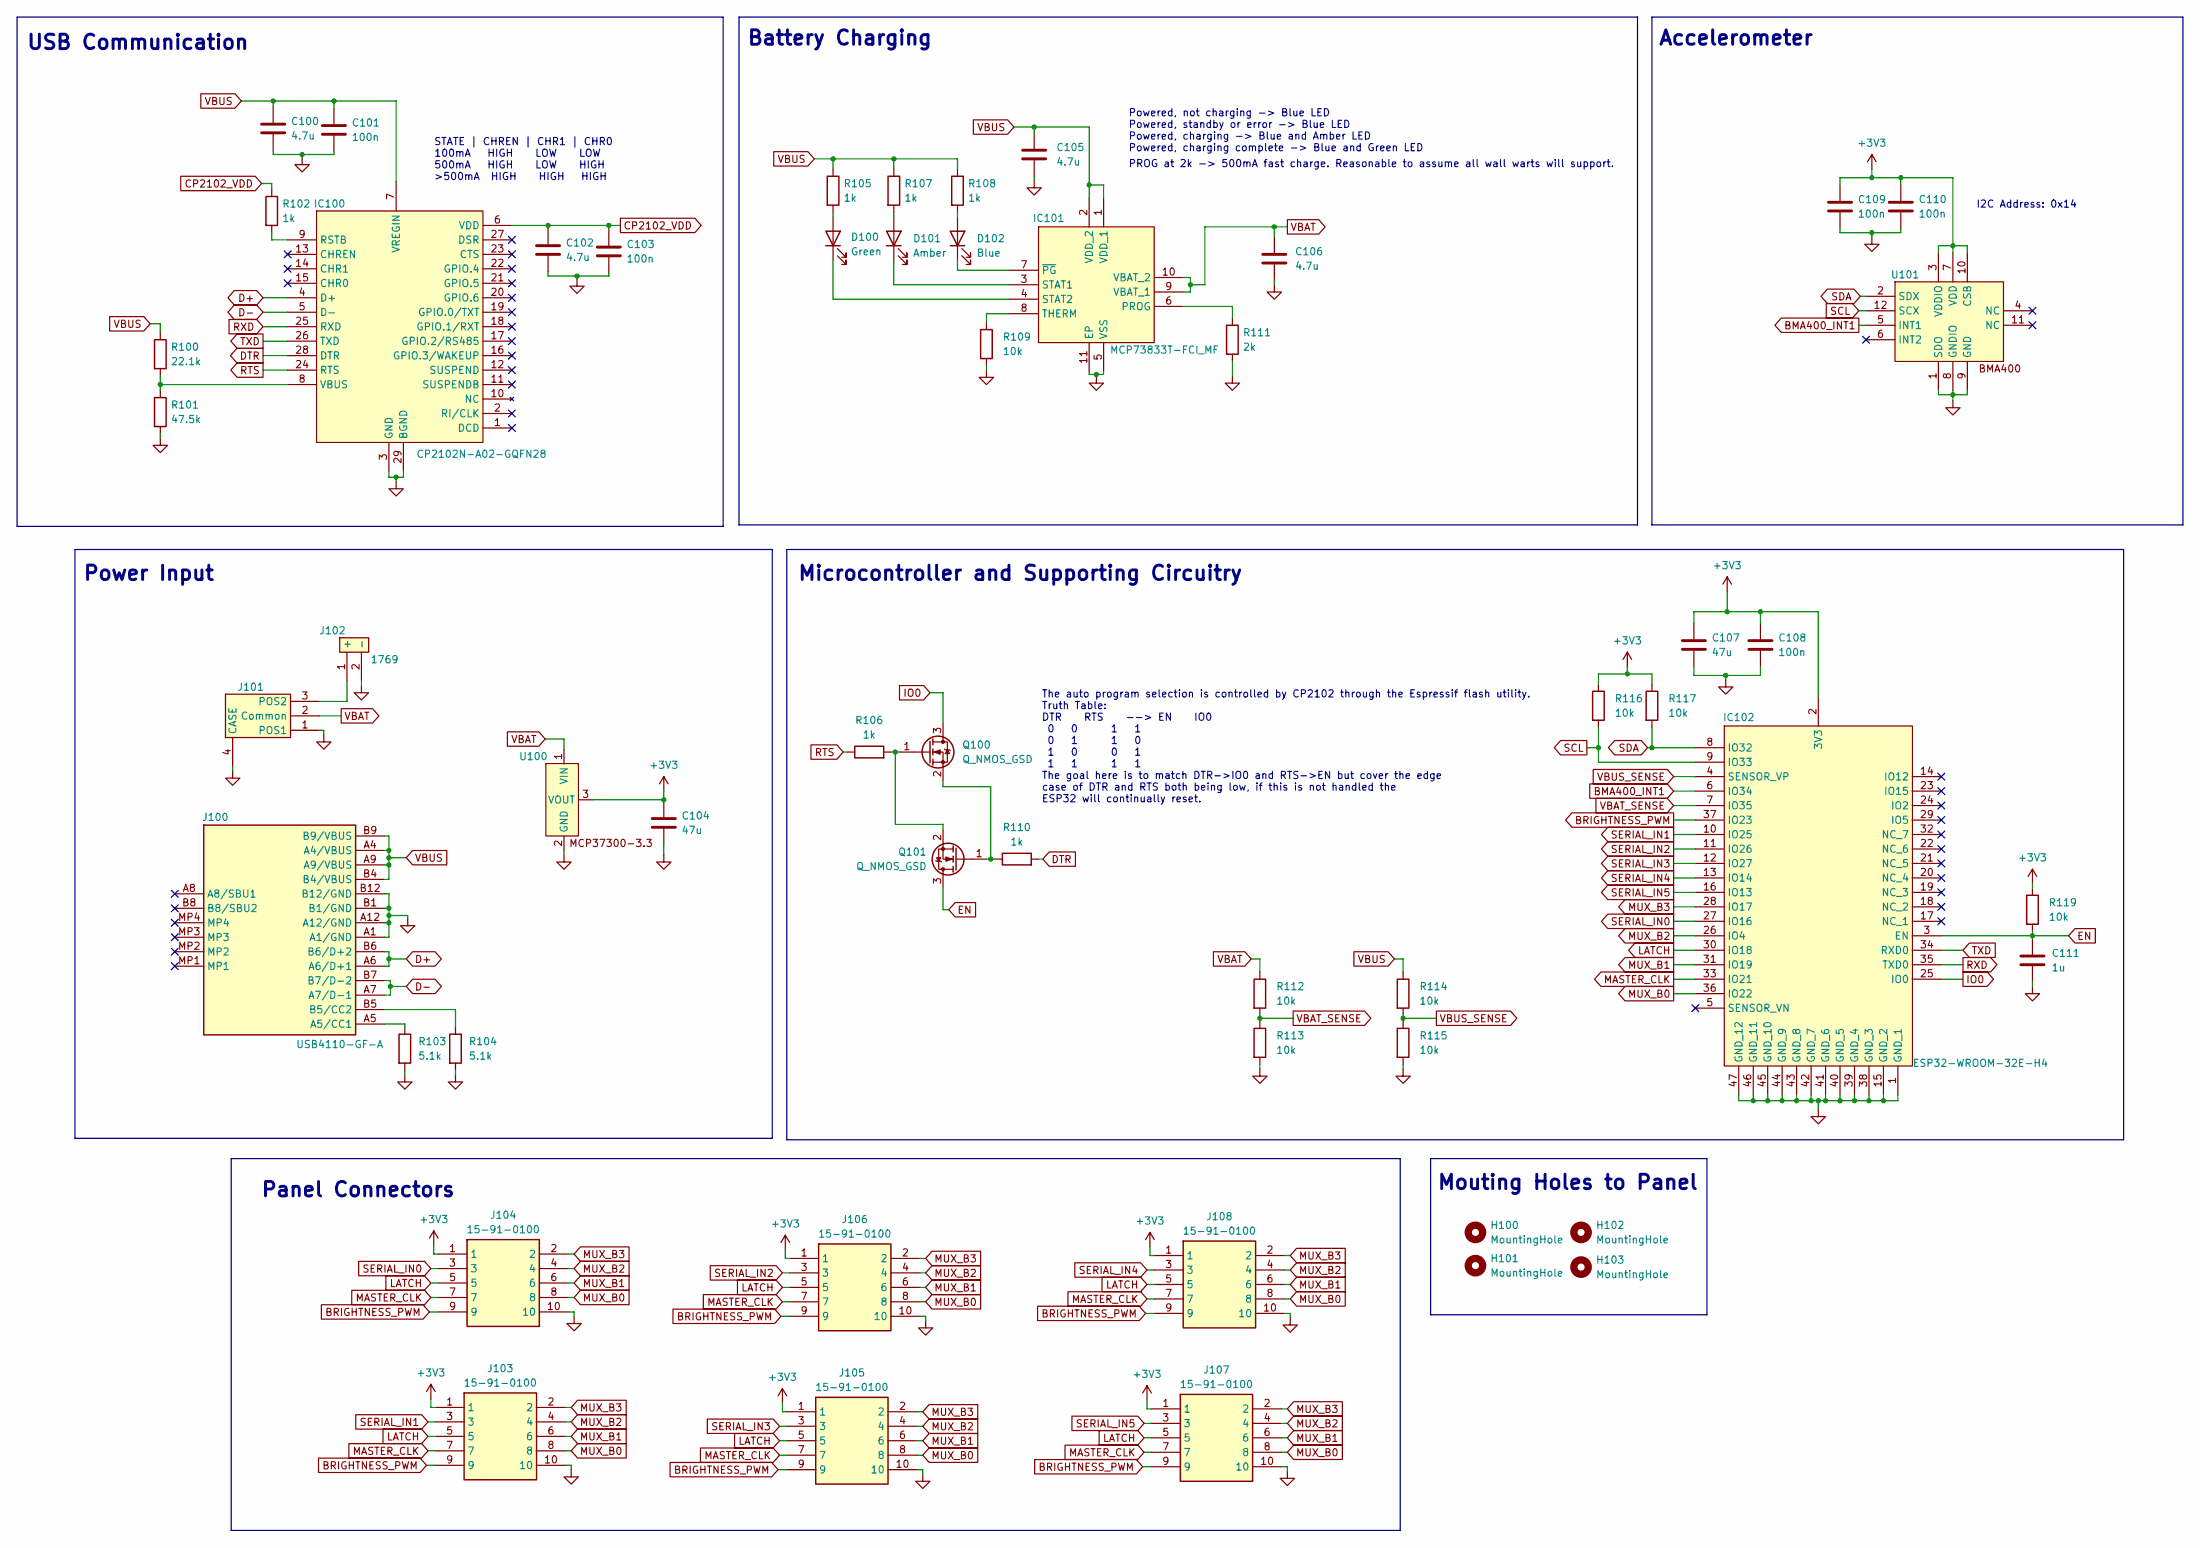
[picture p8: schematic LEDCube.kicad_sch, Main Microcontroller and Power]

Parts:
C100, C102, C105, C106: 4.7u; C_0603_1608Metric
C101, C103, C108, C109, C110: 100n; C_0603_1608Metric
C104, C107: 47u; C_1206_3216Metric
C111: 1u; C_0603_1608Metric
D100: Green; LED_0603_1608Metric
D101: Amber; LED_0603_1608Metric
D102: Blue; LED_0603_1608Metric
H100, H101, H102, H103: MountingHole; MountingHole_3.2mm_M3_Pad_Via
IC100: CP2102N-A02-GQFN28; QFN50P500X500X80-29N-D; Mouser Part Number 634-CP2102NA02GQFN28
IC101: MCP73833T-FCI_MF; SON50P300X300X100-11N-D; Mouser Part Number 579-MCP73833T-FCI/MF
IC102: ESP32-WROOM-32E-H4; ESP32WROOM32EH4; Mouser Part Number 356-ESP32WRM320EH3PS
J100: USB4110-GF-A; USB4110GFA; Mouser Part Number 640-USB4110-GF-A
J101: PowerSwitch
J102: 1769; Mouser Part Number 485-1769
J103, J105, J106, J107, J108: 15-91-0100; CNC_TECH_SMD_10POS; Mouser Part Number 538-15-91-0100
J104: 15-91-0100; CNC_TECH_SMD_10POS; Manufacturer_Part_Number 15-91-0100
Q100, Q101: Q_NMOS_GSD; SOT96P237X111-3N
R100: 22.1k; R_0603_1608Metric
R101: 47.5k; R_0603_1608Metric
R102, R105, R106, R107, R108, R110: 1k; R_0603_1608Metric
R103, R104: 5.1k; R_0603_1608Metric
R109, R112, R113, R114, R115, R116, R117, R119: 10k; R_0603_1608Metric
R111: 2k; R_0603_1608Metric
U100: MIC37300-3.3-SPAK3
U101: BOSCH_LGA-12

Connections:
+3V3: C104.1, C107.1, C108.1, C109.1, C110.1, IC102.2 (3V3), J103.1, J104.1, J105.1, J106.1, J107.1, J108.1, R116.1, R117.1, R119.1, U100.3 (VOUT), U101.3 (VDDIO), U101.7 (VDD), U101.10 (CSB)
BMA400_INT1: IC102.6 (IO34), U101.5 (INT1)
BRIGHTNESS_PWM: IC102.37 (IO23), J103.9, J104.9, J105.9, J106.9, J107.9, J108.9
CP2102_VDD: C102.1, C103.1, IC100.6 (VDD), R102.1
D+: IC100.4 (D+), J100.A6 (A6/D+1), J100.B6 (B6/D+2)
D-: IC100.5 (D-), J100.A7 (A7/D-1), J100.B7 (B7/D-2)
DTR: IC100.28 (DTR), R110.2
EN: C111.1, IC102.3 (EN), Q101.3 (D), R119.2
GND: C100.2, C101.2, C102.2, C103.2, C104.2, C105.2, C106.2, C107.2, C108.2, C109.2, C110.2, C111.2, H100.1, H101.1, H102.1, H103.1, IC100.3 (GND), IC100.29 (BGND), IC101.5 (VSS), IC101.11 (EP), IC102.1 (GND_1), IC102.15 (GND_2), IC102.38 (GND_3), IC102.39 (GND_4), IC102.40 (GND_5), IC102.41 (GND_6), IC102.42 (GND_7), IC102.43 (GND_8), IC102.44 (GND_9), IC102.45 (GND_10), IC102.46 (GND_11), IC102.47 (GND_12), J100.A1 (A1/GND), J100.A12 (A12/GND), J100.B1 (B1/GND), J100.B12 (B12/GND), J101.1 (POS1), J101.4 (CASE), J102.2 (-), J103.10, J104.10, J105.10, J106.10, J107.10, J108.10, R101.2, R103.2, R104.2, R109.2, R111.2, R113.2, R115.2, U100.2 (GND), U101.1 (SDO), U101.8 (GNDIO), U101.9 (GND)
IO0: IC102.25 (IO0), Q100.3 (D)
LATCH: IC102.30 (IO18), J103.5, J104.5, J105.5, J106.5, J107.5, J108.5
MASTER_CLK: IC102.33 (IO21), J103.7, J104.7, J105.7, J106.7, J107.7, J108.7
MUX_B0: IC102.36 (IO22), J103.8, J104.8, J105.8, J106.8, J107.8, J108.8
MUX_B1: IC102.31 (IO19), J103.6, J104.6, J105.6, J106.6, J107.6, J108.6
MUX_B2: IC102.26 (IO4), J103.4, J104.4, J105.4, J106.4, J107.4, J108.4
MUX_B3: IC102.28 (IO17), J103.2, J104.2, J105.2, J106.2, J107.2, J108.2
unnamed: D100.2 (A), R105.2
unnamed: D100.1 (K), IC101.4 (STAT2)
unnamed: D101.2 (A), R107.2
unnamed: D101.1 (K), IC101.3 (STAT1)
unnamed: D102.2 (A), R108.2
unnamed: D102.1 (K), IC101.7 (~PG)
unnamed: IC100.9 (RSTB), R102.2
unnamed: IC100.8 (VBUS), R100.2, R101.1
unnamed: IC101.6 (PROG), R111.1
unnamed: IC101.8 (THERM), R109.1
unnamed: J100.A5 (A5/CC1), R103.1
unnamed: J100.B5 (B5/CC2), R104.1
unnamed: J101.3 (POS2), J102.1 (+)
unnamed: Q100.1 (G), Q101.2 (S), R106.2
unnamed: Q100.2 (S), Q101.1 (G), R110.1
RTS: IC100.24 (RTS), R106.1
RXD: IC100.25 (RXD), IC102.35 (TXD0)
SCL: IC102.9 (IO33), R116.2, U101.12 (SCX)
SDA: IC102.8 (IO32), R117.2, U101.2 (SDX)
SERIAL_IN0: IC102.27 (IO16), J104.3
SERIAL_IN1: IC102.10 (IO25), J103.3
SERIAL_IN2: IC102.11 (IO26), J106.3
SERIAL_IN3: IC102.12 (IO27), J105.3
SERIAL_IN4: IC102.13 (IO14), J108.3
SERIAL_IN5: IC102.16 (IO13), J107.3
TXD: IC100.26 (TXD), IC102.34 (RXD0)
VBAT: C106.1, IC101.9 (VBAT_1), IC101.10 (VBAT_2), J101.2 (Common), R112.1, U100.1 (VIN)
VBAT_SENSE: IC102.7 (IO35), R112.2, R113.1
VBUS: C100.1, C101.1, C105.1, IC100.7 (VREGIN), IC101.1 (VDD_1), IC101.2 (VDD_2), J100.A4 (A4/VBUS), J100.A9 (A9/VBUS), J100.B4 (B4/VBUS), J100.B9 (B9/VBUS), R100.1, R105.1, R107.1, R108.1, R114.1
VBUS_SENSE: IC102.4 (SENSOR_VP), R114.2, R115.1

Notes on the sheet:
USB Communication
Accelerometer
Microcontroller and Supporting Circuitry
Mouting Holes to Panel
PROG at 2k -> 500mA fast charge. Reasonable to assume all wall warts will support.
Battery Charging
Panel Connectors
Power Input
Powered, not charging -> Blue LED Powered, standby or error -> Blue LED Powered, charging -> Blue and Amber LED Powered, charging complete -> Blue and Green LED
I2C Address: 0x14
STATE | CHREN | CHR1 | CHR0 100mA HIGH LOW LOW 500mA HIGH LOW HIGH >500mA HIGH HIGH HIGH
The auto program selection is controlled by CP2102 through the Espressif flash utility. Truth Table: DTR RTS --> EN IO0 0 0 1 1 0 1 1 0 1 0 0 1 1 1 1 1 The goal here is to match DTR->IO0 and RTS->EN but cover the edge case of DTR and RTS both being low, if this is not handled the ESP32 will continu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

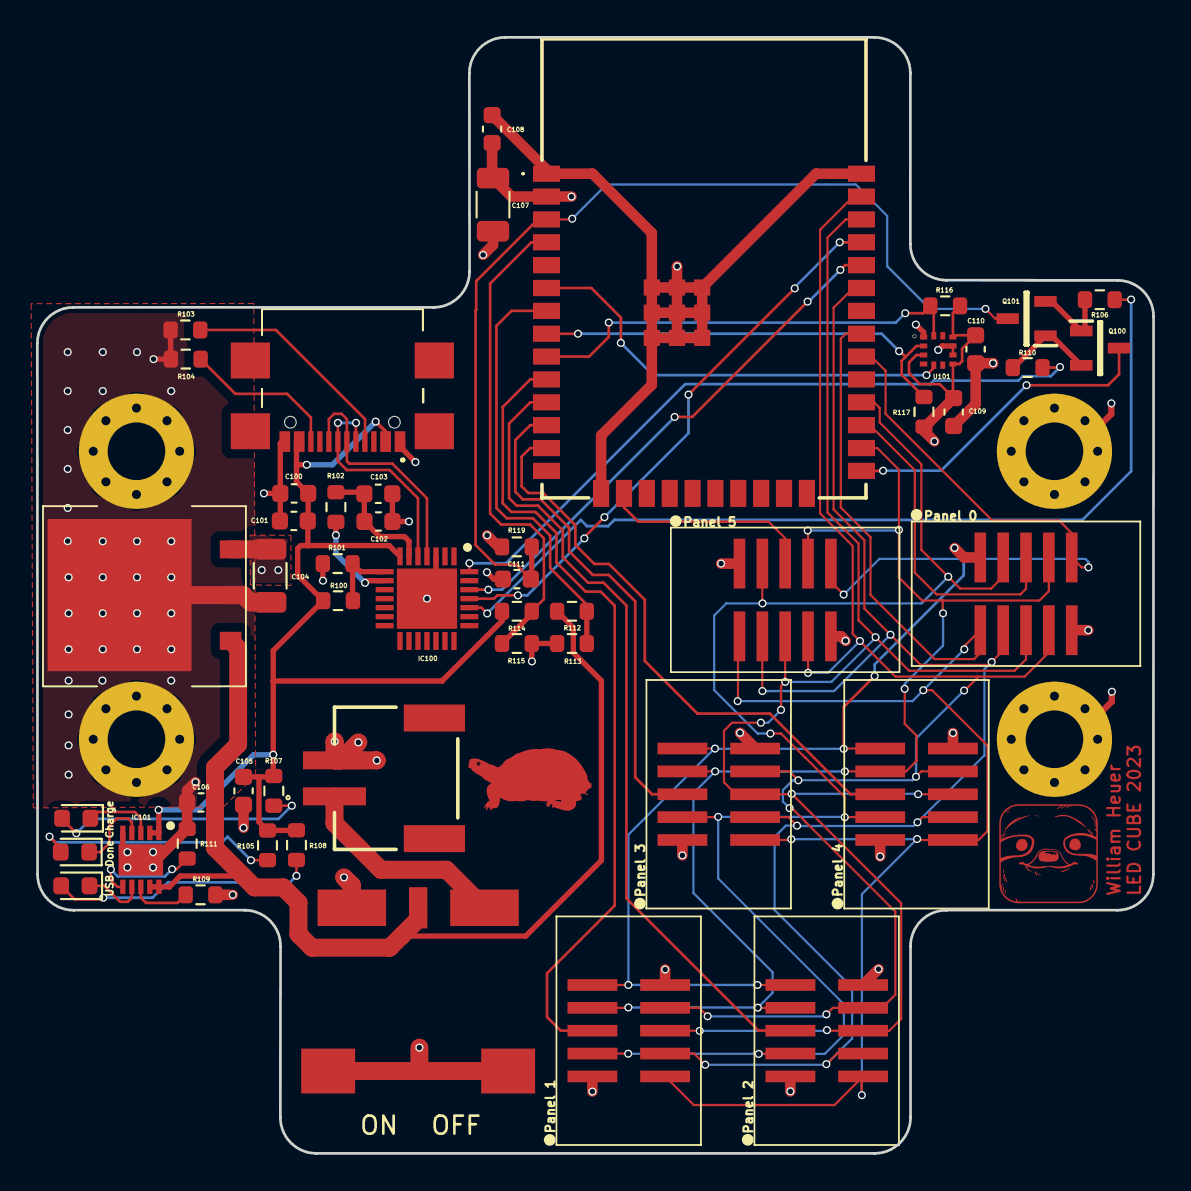
[picture p9: board LEDCube.kicad_pcb from above]

Board: 4 copper layers, 62.0 x 62.0 mm, 54 parts (0 on the bottom side), 46 nets.
