wheuer/LEDCube/(commit log)

2023-09-14 [PCB] Split schematic into two board for easier routing
    [KiCadPanel.kicad_pcb, KiCadPanel.kicad_sch, LEDCube.kicad_pcb, LEDCube.kicad_sch, LED_Array.kicad_sch, LED_Matrix.kicad_sch, PlateCircuitry.kicad_sch]
2023-10-04 Update for MTE
    [KiCadPanel-B_Cu.gbr, KiCadPanel-B_Mask.gbr, KiCadPanel-B_Paste.gbr, KiCadPanel-B_Silkscreen.gbr, KiCadPanel-Edge_Cuts.gbr, KiCadPanel-F_Cu.gbr, KiCadPanel-F_Mask.gbr, KiCadPanel-F_Paste.gbr]
2024-10-05 [Firmware] Simple updating firmware complete
    [LEDCube.kicad_sch]
2024-10-13 [Power] Get battery measurement and basic charger logic implemented
